forestcaver/Tides2_stuff/README.md

# Tides2_stuff
Panel, modified pcb to put the recom on the back, calibration stuff
(pcb and panel both verified - two modules built 11/4/19)
