forestcaver/Tides2_stuff/tides2_panel_AJH3.bmp

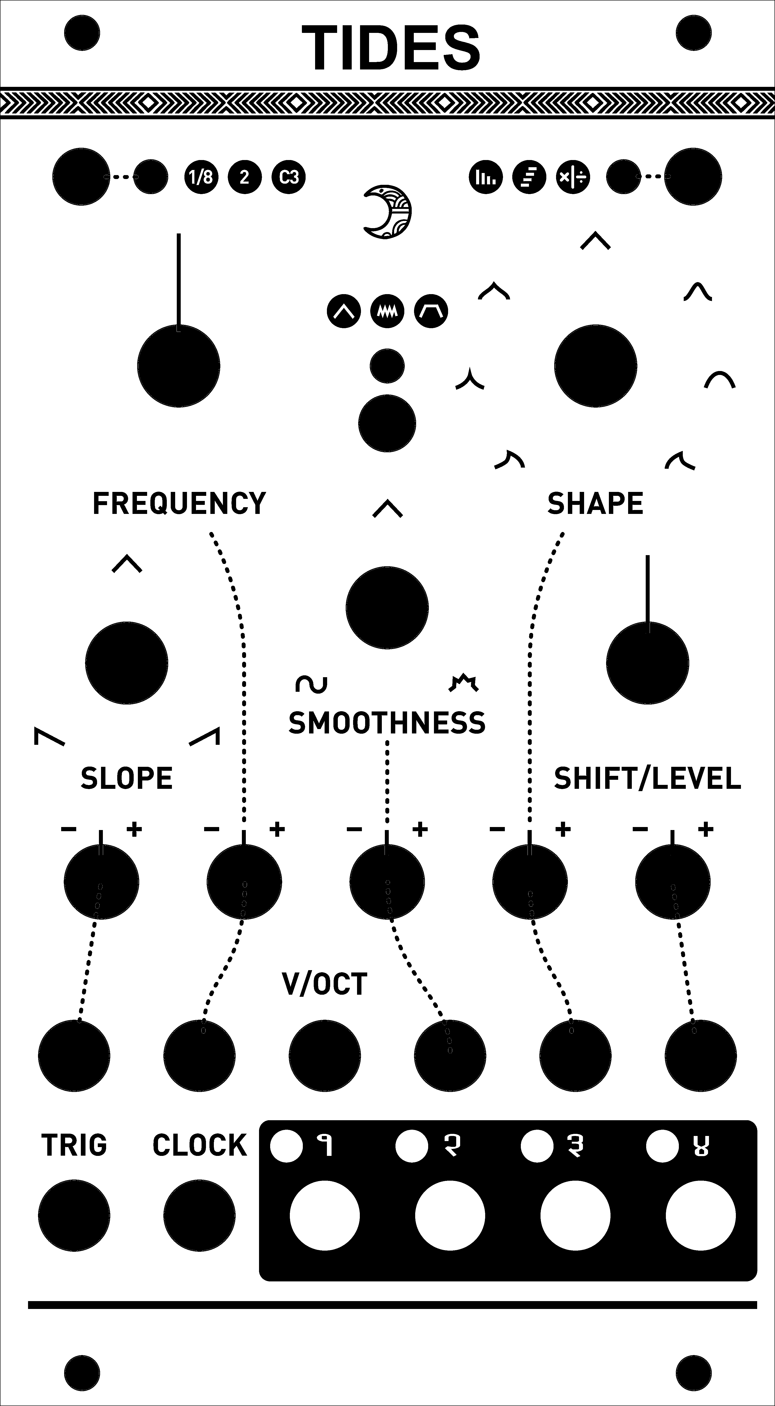
tides2_panel_AJH3.bmp
