forestcaver/Tides2_stuff/AJH_tides2_v40.brd

## EAGLE design AJH_tides2_v40.brd (2019-04-13)

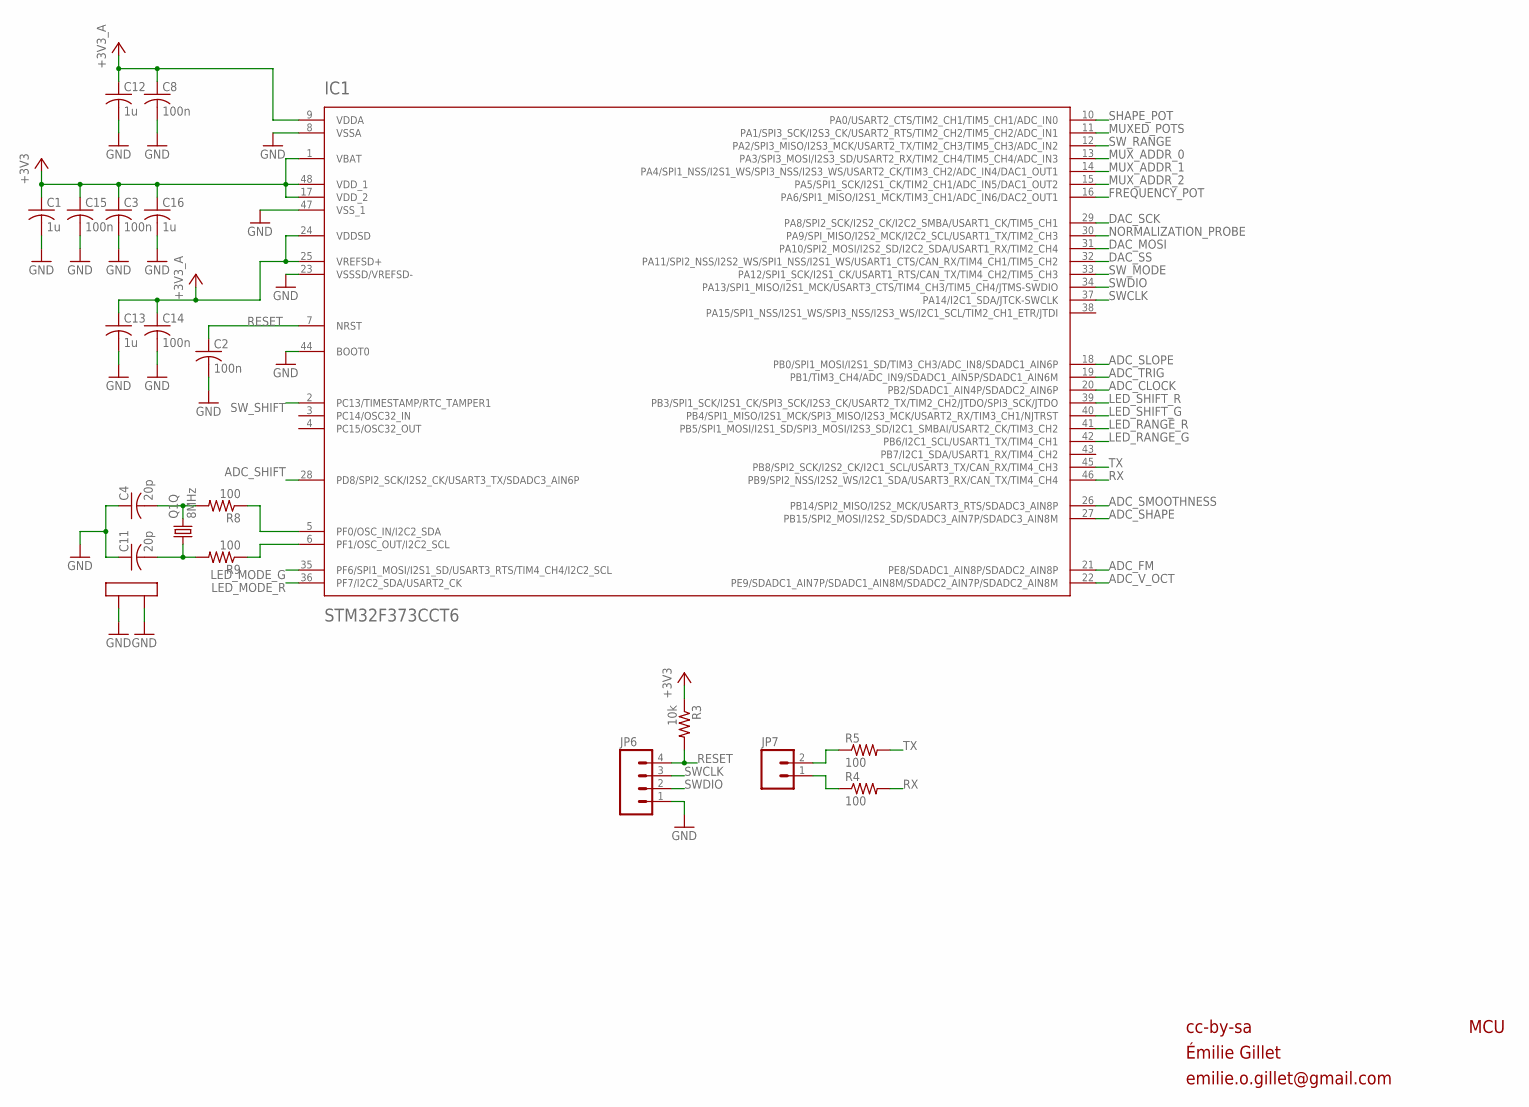
[picture p2: schematic AJH_tides2_v40.sch, sheet 1]

Parts:
C1, C12, C13, C16: 1u; C0402
C2, C3, C8, C14, C15: 100n; C0402
C4, C11: 20p; C0402
IC1: STM32F373CCT6; LQFP48
JP6: M04PTH; 1X04
JP7: M02PTH; 1X02
Q1: 8MHz; CTS406
R3: 10k; R0402
R4, R5, R8, R9: 100; R0402

Connections:
+3V3: C1.1, C3.1, C15.1, C16.1, IC1.1 (VBAT), IC1.17 (VDD_2), IC1.48 (VDD_1), R3.1; also elsewhere on the board
+3V3_A: C8.1, C12.1, C13.1, C14.1, IC1.9 (VDDA), IC1.24 (VDDSD), IC1.25 (VREFSD+); also elsewhere on the board
ADC_CLOCK: IC1.20 (PB2/SDADC1_AIN4P/SDADC2_AIN6P); also elsewhere on the board
ADC_FM: IC1.21 (PE8/SDADC1_AIN8P/SDADC2_AIN8P); also elsewhere on the board
ADC_SHAPE: IC1.27 (PB15/SPI2_MOSI/I2S2_SD/SDADC3_AIN7P/SDA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); also elsewhere on the board
ADC_SHIFT: IC1.28 (PD8/SPI2_SCK/I2S2_CK/USART3_TX/SDADC3_A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); also elsewhere on the board
ADC_SLOPE: IC1.18 (PB0/SPI1_MOSI/I2S1_SD/TIM3_CH3/ADC_IN8/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); also elsewhere on the board
ADC_SMOOTHNESS: IC1.26 (PB14/SPI2_MISO/I2S2_MCK/USART3_RTS/SDAD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); also elsewhere on the board
ADC_TRIG: IC1.19 (PB1/TIM3_CH4/ADC_IN9/SDADC1_AIN5P/SDADC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); also elsewhere on the board
ADC_V_OCT: IC1.22 (PE9/SDADC1_AIN7P/SDADC1_AIN8M/SDADC2_AI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); also elsewhere on the board
DAC_MOSI: IC1.31 (PA10/SPI2_MOSI/I2S2_SD/I2C2_SDA/USART1_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); also elsewhere on the board
DAC_SCK: IC1.29 (PA8/SPI2_SCK/I2S2_CK/I2C2_SMBA/USART1_C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); also elsewhere on the board
DAC_SS: IC1.32 (PA11/SPI2_NSS/I2S2_WS/SPI1_NSS/I2S1_WS/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); also elsewhere on the board
FREQUENCY_POT: IC1.16 (PA6/SPI1_MISO/I2S1_MCK/TIM3_CH1/ADC_IN6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); also elsewhere on the board
GND: C1.2, C2.2, C3.2, C4.1, C8.2, C11.1, C12.2, C13.2, C14.2, C15.2, C16.2, IC1.8 (VSSA), IC1.23 (VSSSD/VREFSD-), IC1.44 (BOOT0), IC1.47 (VSS_1), JP6.1, Q1.2 (LID1), Q1.4 (LID2); also elsewhere on the board
LED_MODE_G: IC1.35 (PF6/SPI1_MOSI/I2S1_SD/USART3_RTS/TIM4_C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); also elsewhere on the board
LED_MODE_R: IC1.36 (PF7/I2C2_SDA/USART2_CK); also elsewhere on the board
LED_RANGE_G: IC1.42 (PB6/I2C1_SCL/USART1_TX/TIM4_CH1); also elsewhere on the board
LED_RANGE_R: IC1.41 (PB5/SPI1_MOSI/I2S1_SD/SPI3_MOSI/I2S3_SD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); also elsewhere on the board
LED_SHIFT_G: IC1.40 (PB4/SPI1_MISO/I2S1_MCK/SPI3_MISO/I2S3_M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); also elsewhere on the board
LED_SHIFT_R: IC1.39 (PB3/SPI1_SCK/I2S1_CK/SPI3_SCK/I2S3_CK/U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); also elsewhere on the board
MUXED_POTS: IC1.11 (PA1/SPI3_SCK/I2S3_CK/USART2_RTS/TIM2_CH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); also elsewhere on the board
MUX_ADDR_0: IC1.13 (PA3/SPI3_MOSI/I2S3_SD/USART2_RX/TIM2_CH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); also elsewhere on the board
MUX_ADDR_1: IC1.14 (PA4/SPI1_NSS/I2S1_WS/SPI3_NSS/I2S3_WS/U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); also elsewhere on the board
MUX_ADDR_2: IC1.15 (PA5/SPI1_SCK/I2S1_CK/TIM2_CH1/ADC_IN5/D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); also elsewhere on the board
unnamed: IC1.5 (PF0/OSC_IN/I2C2_SDA), R8.1
unnamed: IC1.6 (PF1/OSC_OUT/I2C2_SCL), R9.1
unnamed: C4.2, Q1.3 (2), R8.2
unnamed: JP7.2, R5.1
unnamed: C11.2, Q1.1, R9.2
unnamed: JP7.1, R4.1
NORMALIZATION_PROBE: IC1.30 (PA9/SPI_MISO/I2S2_MCK/I2C2_SCL/USART1_T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); also elsewhere on the board
RESET: C2.1, IC1.7 (NRST), JP6.4, R3.2
RX: IC1.46 (PB9/SPI2_NSS/I2S2_WS/I2C1_SDA/USART3_RX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), R4.2
SHAPE_POT: IC1.10 (PA0/USART2_CTS/TIM2_CH1/TIM5_CH1/ADC_IN0); also elsewhere on the board
SWCLK: IC1.37 (PA14/I2C1_SDA/JTCK-SWCLK), JP6.3
SWDIO: IC1.34 (PA13/SPI1_MISO/I2S1_MCK/USART3_CTS/TIM4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), JP6.2
SW_MODE: IC1.33 (PA12/SPI1_SCK/I2S1_CK/USART1_RTS/CAN_TX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); also elsewhere on the board
SW_RANGE: IC1.12 (PA2/SPI3_MISO/I2S3_MCK/USART2_TX/TIM2_C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); also elsewhere on the board
SW_SHIFT: IC1.2 (PC13/TIMESTAMP/RTC_TAMPER1); also elsewhere on the board
TX: IC1.45 (PB8/SPI2_SCK/I2S2_CK/I2C1_SCL/USART3_TX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), R5.2

Notes on the sheet:
cc-by-sa
MCU
Émilie Gillet
emilie.o.gillet@gmail.com

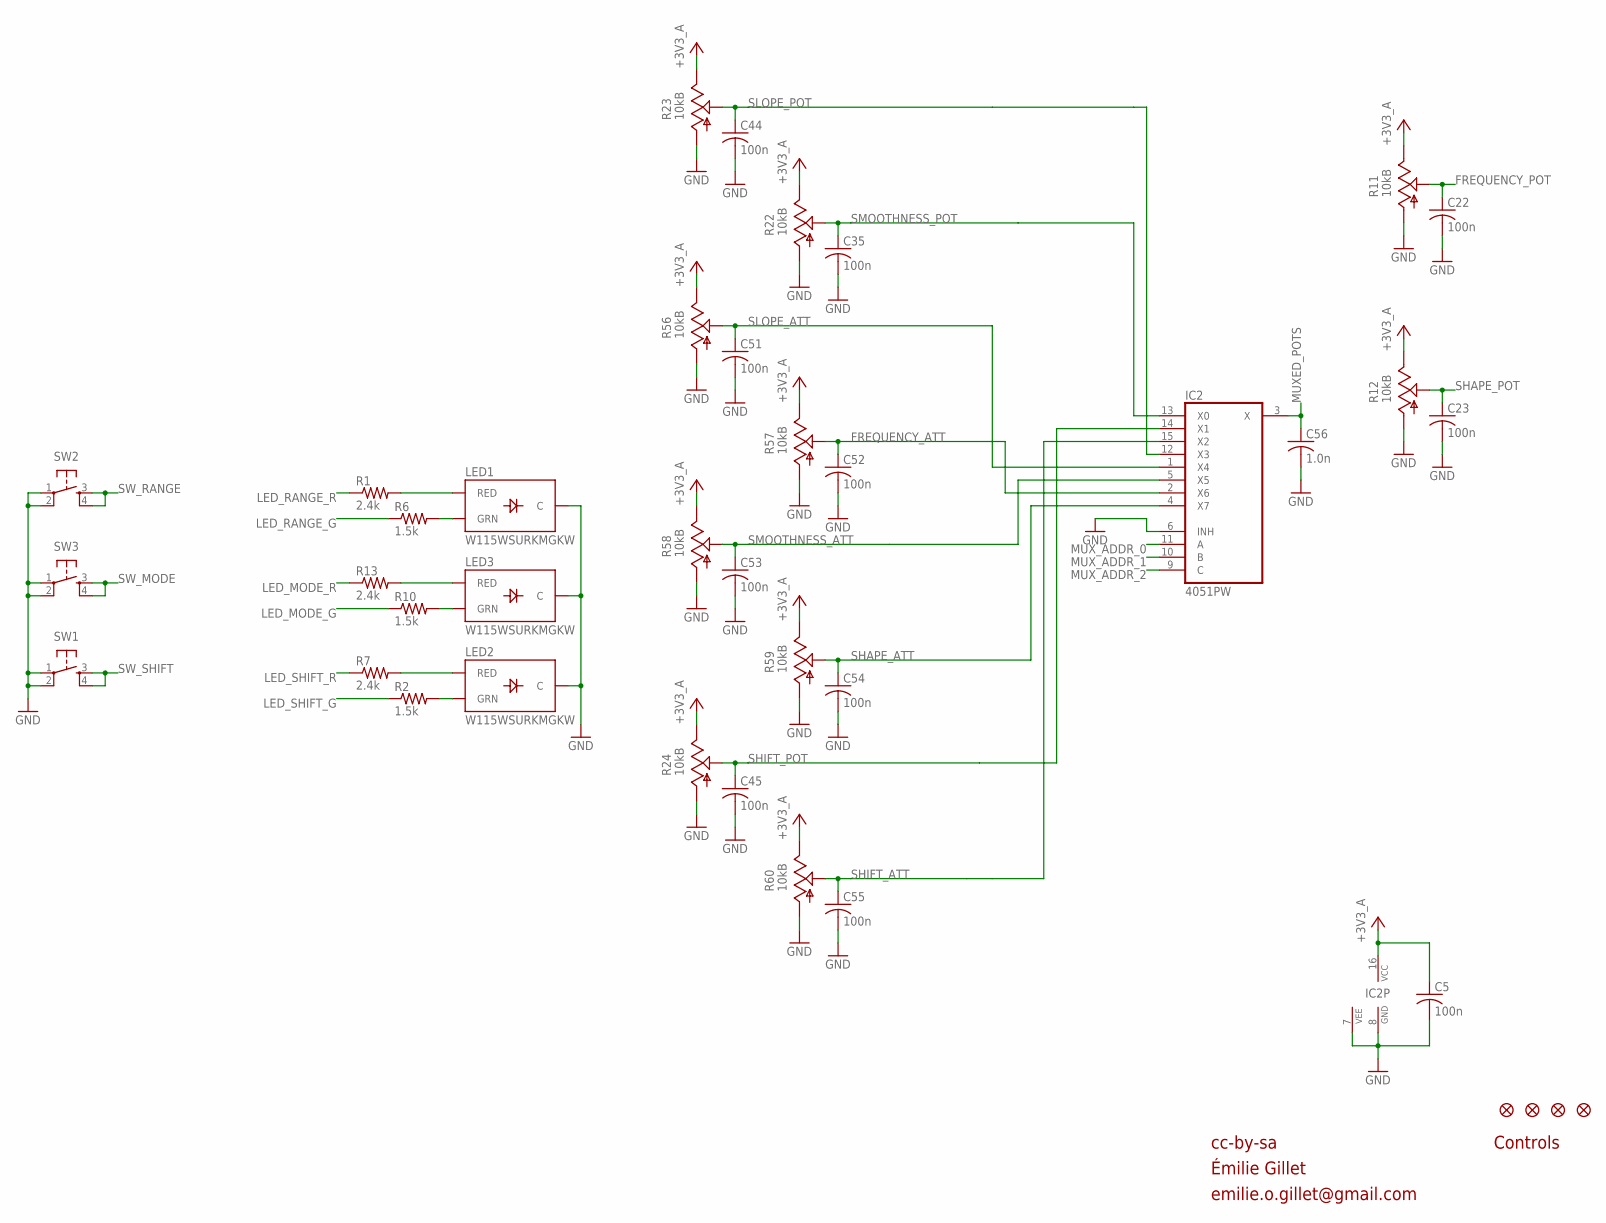
[picture p3: schematic AJH_tides2_v40.sch, sheet 2]

Parts:
C5, C22, C23, C35, C44, C45, C51, C52, C53, C54, C55: 100n; C0402
C56: 1.0n; C0402
IC2: 4051PW; TSSOP16_065
JP1, JP2, JP3, JP4: FIDUCIAL1X2; FIDUCIAL-1X2
LED1, LED2, LED3: W115WSURKMGKW; LED-BICOLOR-THROUGHHOLE-2.54
R1, R7, R13: 2.4k; R0402
R2, R6, R10: 1.5k; R0402
R11, R12, R22, R23, R24: 10kB; ALPS_POT_VERTICAL_PS
R56, R57, R58, R59, R60: 10kB; ALPS_POT_VERTICAL
SW1, SW2, SW3: TAC_SWITCHPTH; TACTILE-PTH

Connections:
+3V3_A: C5.1, IC2.16 (VCC), R11.P$1 (E), R12.P$1 (E), R22.P$1 (E), R23.P$1 (E), R24.P$1 (E), R56.P$1 (E), R57.P$1 (E), R58.P$1 (E), R59.P$1 (E), R60.P$1 (E); also elsewhere on the board
FREQUENCY_ATT: C52.1, IC2.2 (X6), R57.P$2 (S)
FREQUENCY_POT: C22.1, R11.P$2 (S); also elsewhere on the board
GND: C5.2, C22.2, C23.2, C35.2, C44.2, C45.2, C51.2, C52.2, C53.2, C54.2, C55.2, C56.2, IC2.6 (INH), IC2.7 (VEE), IC2.8 (GND), LED1.2 (C), LED2.2 (C), LED3.2 (C), R11.P$3 (A), R12.P$3 (A), R22.P$3 (A), R23.P$3 (A), R24.P$3 (A), R56.P$3 (A), R57.P$3 (A), R58.P$3 (A), R59.P$3 (A), R60.P$3 (A), SW1.1, SW1.2, SW2.1, SW2.2, SW3.1, SW3.2; also elsewhere on the board
LED_MODE_G: R10.1; also elsewhere on the board
LED_MODE_R: R13.1; also elsewhere on the board
LED_RANGE_G: R6.1; also elsewhere on the board
LED_RANGE_R: R1.1; also elsewhere on the board
LED_SHIFT_G: R2.1; also elsewhere on the board
LED_SHIFT_R: R7.1; also elsewhere on the board
MUXED_POTS: C56.1, IC2.3 (X); also elsewhere on the board
MUX_ADDR_0: IC2.11 (A); also elsewhere on the board
MUX_ADDR_1: IC2.10 (B); also elsewhere on the board
MUX_ADDR_2: IC2.9 (C); also elsewhere on the board
unnamed: LED1.3 (RED), R1.2
unnamed: LED3.3 (RED), R13.2
unnamed: LED3.1 (GRN), R10.2
unnamed: LED2.3 (RED), R7.2
unnamed: LED1.1 (GRN), R6.2
unnamed: LED2.1 (GRN), R2.2
SHAPE_ATT: C54.1, IC2.4 (X7), R59.P$2 (S)
SHAPE_POT: C23.1, R12.P$2 (S); also elsewhere on the board
SHIFT_ATT: C55.1, IC2.15 (X2), R60.P$2 (S)
SHIFT_POT: C45.1, IC2.14 (X1), R24.P$2 (S)
SLOPE_ATT: C51.1, IC2.1 (X4), R56.P$2 (S)
SLOPE_POT: C44.1, IC2.12 (X3), R23.P$2 (S)
SMOOTHNESS_ATT: C53.1, IC2.5 (X5), R58.P$2 (S)
SMOOTHNESS_POT: C35.1, IC2.13 (X0), R22.P$2 (S)
SW_MODE: SW3.3, SW3.4; also elsewhere on the board
SW_RANGE: SW2.3, SW2.4; also elsewhere on the board
SW_SHIFT: SW1.3, SW1.4; also elsewhere on the board

Notes on the sheet:
cc-by-sa
Controls
Émilie Gillet
emilie.o.gillet@gmail.com

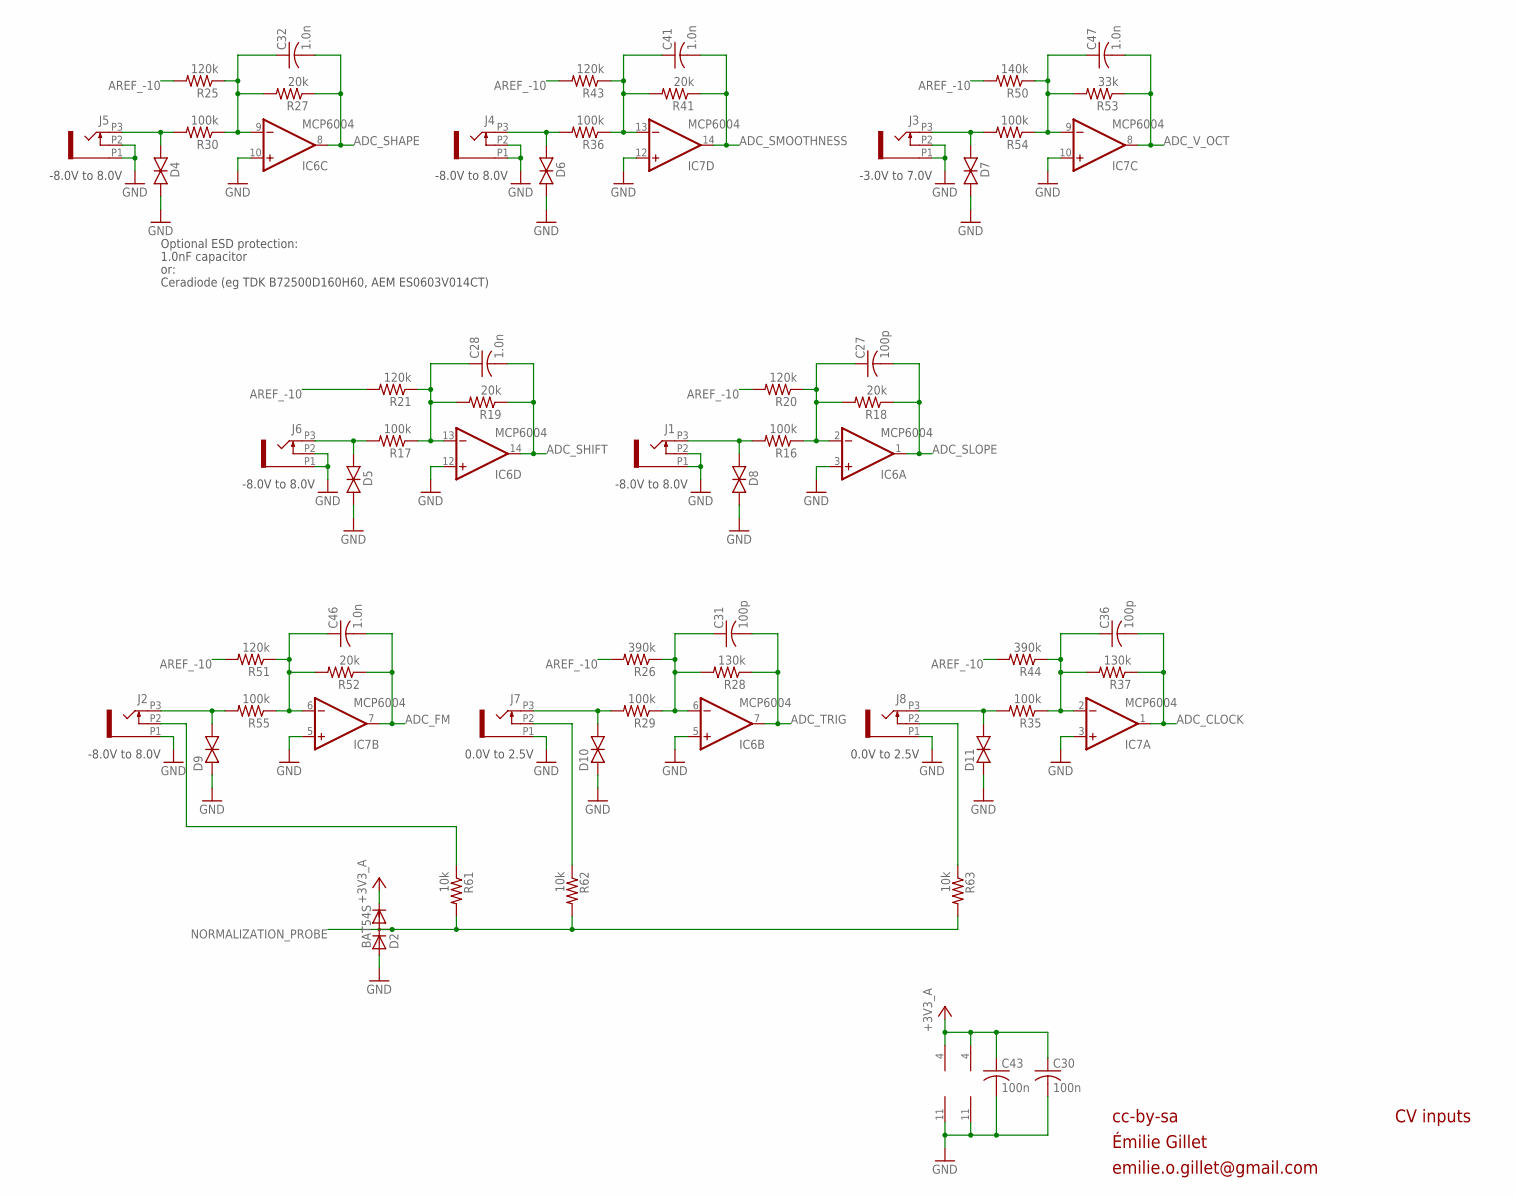
[picture p4: schematic AJH_tides2_v40.sch, sheet 3]

Parts:
C27, C31, C36: 100p; C0402
C28, C32, C41, C46, C47: 1.0n; C0402
C30, C43: 100n; C0402
D2: BAT54S; SOT23
D4, D5, D6, D7, D8, D9, D10, D11: TVS; 0603
IC6, IC7: MCP6004; TSSOP14_065
J1, J2, J3, J4, J5, J6, J7, J8: PJ301_THONKICONN6; WQP_PJ_301M6
R16, R17, R29, R30, R35, R36, R54, R55: 100k; R0402
R18, R19, R27, R41, R52: 20k; R0402
R20, R21, R25, R43, R51: 120k; R0402
R26, R44: 390k; R0402
R28, R37: 130k; R0402
R50: 140k; R0402
R53: 33k; R0402
R61, R62, R63: 10k; R0402

Connections:
+3V3_A: C30.1, C43.1, D2.2 (C), IC6.4 (V+), IC7.4 (V+); also elsewhere on the board
ADC_CLOCK: C36.2, IC7.1 (OUT), R37.1; also elsewhere on the board
ADC_FM: C46.2, IC7.7 (OUT), R52.1; also elsewhere on the board
ADC_SHAPE: C32.2, IC6.8 (OUT), R27.1; also elsewhere on the board
ADC_SHIFT: C28.2, IC6.14 (OUT), R19.1; also elsewhere on the board
ADC_SLOPE: C27.2, IC6.1 (OUT), R18.1; also elsewhere on the board
ADC_SMOOTHNESS: C41.2, IC7.14 (OUT), R41.1; also elsewhere on the board
ADC_TRIG: C31.2, IC6.7 (OUT), R28.1; also elsewhere on the board
ADC_V_OCT: C47.2, IC7.8 (OUT), R53.1; also elsewhere on the board
AREF_-10: R20.2, R21.2, R25.2, R26.2, R43.2, R44.2, R50.2, R51.2; also elsewhere on the board
CLOCK_IN: D11.2 (C), J8.P3 (3), R35.2
FM_IN: D9.2 (C), J2.P3 (3), R55.2
GND: C30.2, C43.2, D2.1 (A), D4.1 (A), D5.1 (A), D6.1 (A), D7.1 (A), D8.1 (A), D9.1 (A), D10.1 (A), D11.1 (A), IC6.3 (+IN), IC6.5 (+IN), IC6.10 (+IN), IC6.11 (V-), IC6.12 (+IN), IC7.3 (+IN), IC7.5 (+IN), IC7.10 (+IN), IC7.11 (V-), IC7.12 (+IN), J1.P1 (1), J1.P2 (2), J2.P1 (1), J3.P1 (1), J3.P2 (2), J4.P1 (1), J4.P2 (2), J5.P1 (1), J5.P2 (2), J6.P1 (1), J6.P2 (2), J7.P1 (1), J8.P1 (1); also elsewhere on the board
unnamed: J7.P2 (2), R62.1
unnamed: J8.P2 (2), R63.1
unnamed: C27.1, IC6.2 (-IN), R16.1, R18.2, R20.1
unnamed: J2.P2 (2), R61.1
unnamed: C28.1, IC6.13 (-IN), R17.1, R19.2, R21.1
unnamed: C47.1, IC7.9 (-IN), R50.1, R53.2, R54.1
unnamed: C46.1, IC7.6 (-IN), R51.1, R52.2, R55.1
unnamed: C31.1, IC6.6 (-IN), R26.1, R28.2, R29.1
unnamed: C32.1, IC6.9 (-IN), R25.1, R27.2, R30.1
unnamed: C36.1, IC7.2 (-IN), R35.1, R37.2, R44.1
unnamed: C41.1, IC7.13 (-IN), R36.1, R41.2, R43.1
NORMALIZATION_PROBE: D2.3 (AC), R61.2, R62.2, R63.2; also elsewhere on the board
SHAPE_IN: D4.2 (C), J5.P3 (3), R30.2
SHIFT_IN: D5.2 (C), J6.P3 (3), R17.2
SLOPE_IN: D8.2 (C), J1.P3 (3), R16.2
SMOOTHNESS_IN: D6.2 (C), J4.P3 (3), R36.2
TRIG_IN: D10.2 (C), J7.P3 (3), R29.2
V_OCT_IN: D7.2 (C), J3.P3 (3), R54.2

Notes on the sheet:
cc-by-sa
CV inputs
-8.0V to 8.0V
-3.0V to 7.0V
0.0V to 2.5V
Optional ESD protection:
1.0nF capacitor
or:
Ceradiode (eg TDK B72500D160H60, AEM ES0603V014CT)
Émilie Gillet
emilie.o.gillet@gmail.com

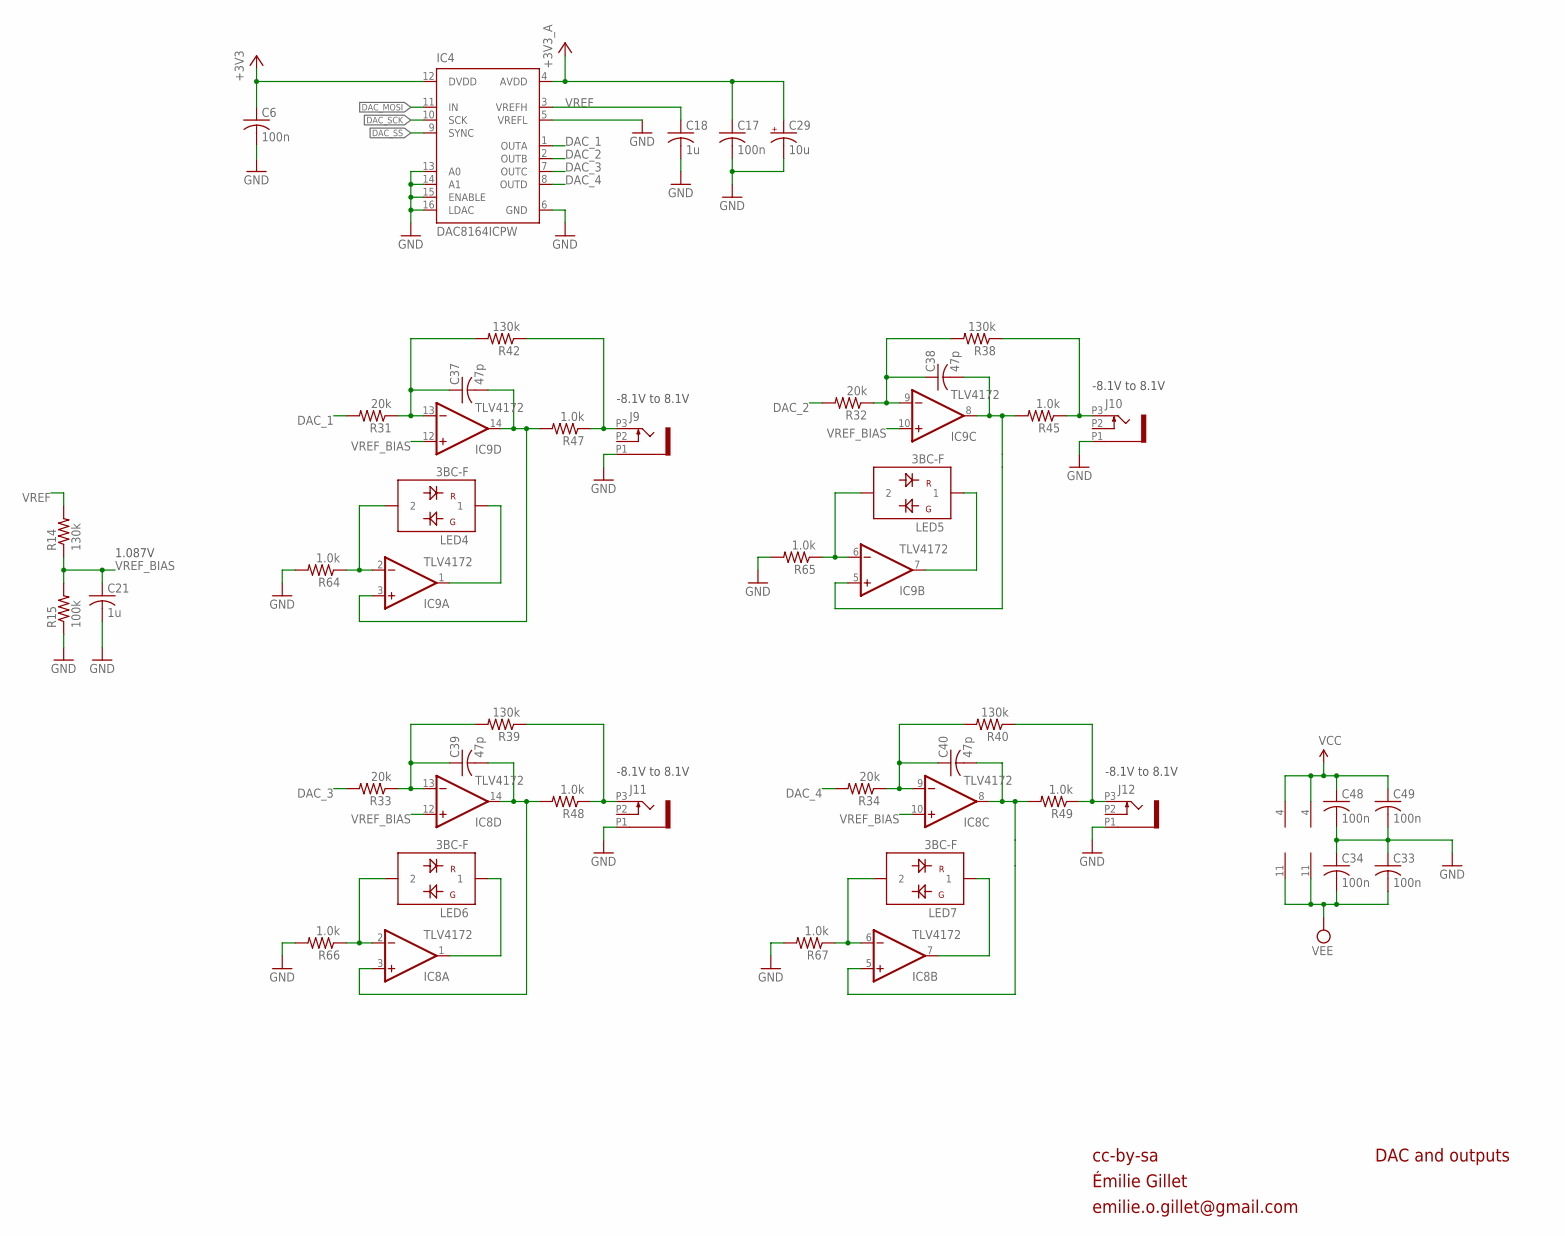
[picture p5: schematic AJH_tides2_v40.sch, sheet 4]

Parts:
C6, C17, C33, C34, C48, C49: 100n; C0402
C18, C21: 1u; C0402
C29: 10u; PANASONIC_A
C37, C38, C39, C40: 47p; C0402
IC4: DAC8164ICPW; SOP65P640X110-16N
IC8, IC9: TLV4172; TSSOP14_065
J9, J10, J11, J12: PJ301_THONKICONN6; WQP_PJ_301M6
LED4, LED5, LED6, LED7: 3BC-F; LED3MM
R14, R38, R39, R40, R42: 130k; R0402
R15: 100k; R0402
R31, R32, R33, R34: 20k; R0402
R45, R47, R48, R49: 1.0k; R0603
R64, R65, R66, R67: 1.0k; R0402

Connections:
+3V3: C6.1, IC4.12 (DVDD); also elsewhere on the board
+3V3_A: C17.1, C29.+, IC4.4 (AVDD); also elsewhere on the board
DAC_1: IC4.1 (OUTA), R31.2
DAC_2: IC4.2 (OUTB), R32.2
DAC_3: IC4.7 (OUTC), R33.2
DAC_4: IC4.8 (OUTD), R34.2
DAC_MOSI: IC4.11 (IN); also elsewhere on the board
DAC_SCK: IC4.10 (SCK); also elsewhere on the board
DAC_SS: IC4.9 (SYNC); also elsewhere on the board
GND: C6.2, C17.2, C18.2, C21.2, C29.-, C33.1, C34.1, C48.2, C49.2, IC4.5 (VREFL), IC4.6 (GND), IC4.13 (A0), IC4.14 (A1), IC4.15 (ENABLE), IC4.16 (LDAC), J9.P1 (1), J10.P1 (1), J11.P1 (1), J12.P1 (1), R15.1, R64.2, R65.2, R66.2, R67.2; also elsewhere on the board
unnamed: C37.2, IC9.3 (+IN), IC9.14 (OUT), R47.2
unnamed: J11.P3 (3), R39.1, R48.1
unnamed: J9.P3 (3), R42.1, R47.1
unnamed: C39.1, IC8.13 (-IN), R33.1, R39.2
unnamed: J12.P3 (3), R40.1, R49.1
unnamed: C40.1, IC8.9 (-IN), R34.1, R40.2
unnamed: C38.1, IC9.9 (-IN), R32.1, R38.2
unnamed: C37.1, IC9.13 (-IN), R31.1, R42.2
unnamed: J10.P3 (3), R38.1, R45.1
unnamed: IC9.2 (-IN), LED4.2, R64.1
unnamed: IC9.1 (OUT), LED4.1
unnamed: C38.2, IC9.5 (+IN), IC9.8 (OUT), R45.2
unnamed: IC9.6 (-IN), LED5.2, R65.1
unnamed: IC9.7 (OUT), LED5.1
unnamed: C39.2, IC8.3 (+IN), IC8.14 (OUT), R48.2
unnamed: IC8.2 (-IN), LED6.2, R66.1
unnamed: IC8.1 (OUT), LED6.1
unnamed: C40.2, IC8.5 (+IN), IC8.8 (OUT), R49.2
unnamed: IC8.6 (-IN), LED7.2, R67.1
unnamed: IC8.7 (OUT), LED7.1
VCC: C48.1, C49.1, IC8.4 (V+), IC9.4 (V+); also elsewhere on the board
VEE: C33.2, C34.2, IC8.11 (V-), IC9.11 (V-); also elsewhere on the board
VREF: C18.1, IC4.3 (VREFH), R14.2
VREF_BIAS: C21.1, IC8.10 (+IN), IC8.12 (+IN), IC9.10 (+IN), IC9.12 (+IN), R14.1, R15.2

Notes on the sheet:
cc-by-sa
DAC and outputs
-8.1V to 8.1V
1.087V
Émilie Gillet
emilie.o.gillet@gmail.com

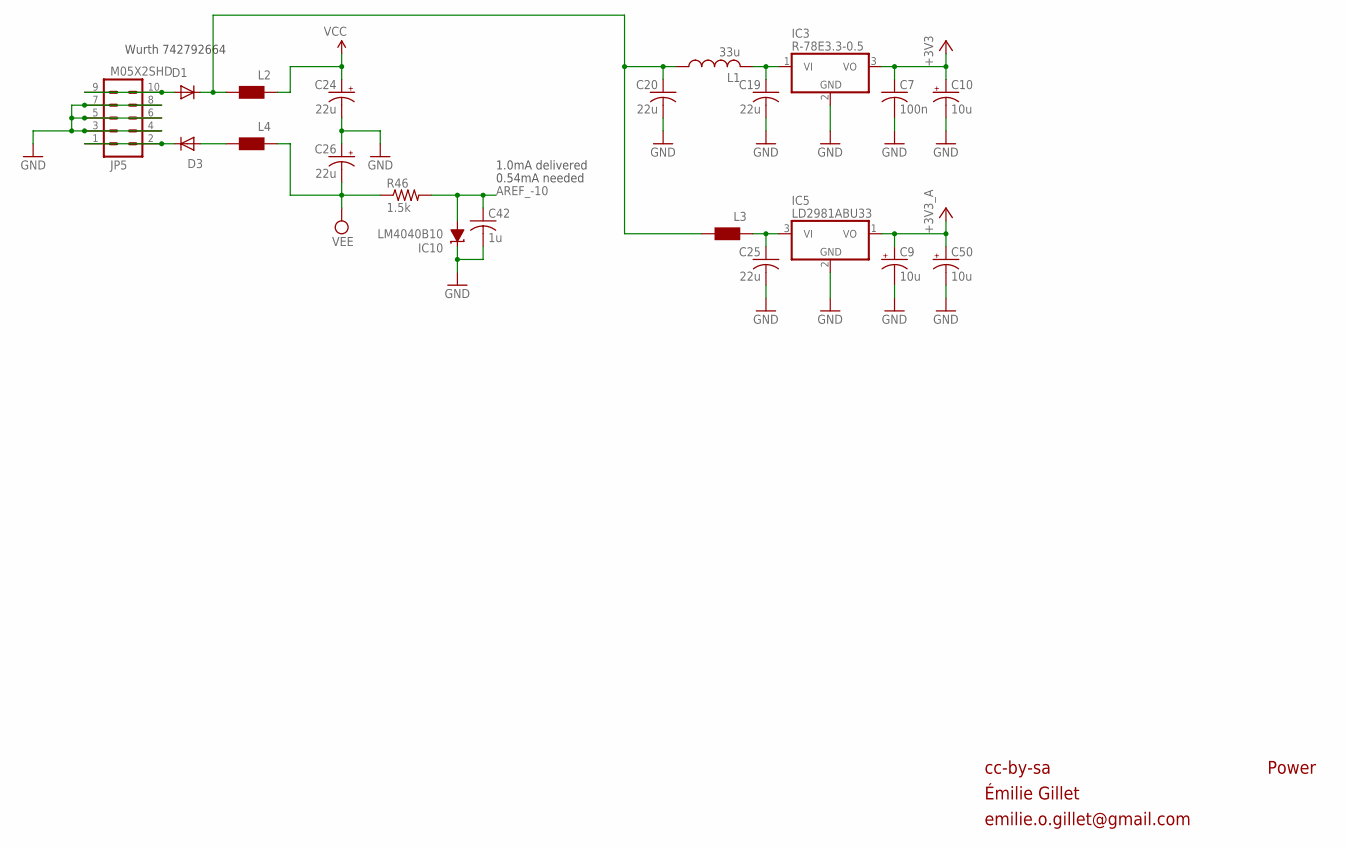
[picture p6: schematic AJH_tides2_v40.sch, sheet 5]

Parts:
C7: 100n; C0402
C9, C10, C50: 10u; PANASONIC_A
C19, C20, C25: 22u; C1206
C24, C26: 22u; PANASONIC_B
C42: 1u; C0402
D1, D3: 1N5819HW; SOD123
IC3: R-78E3.3-0.5; WE78
IC5: LD2981ABU33; SOT89
IC10: LM4040B10; DBZ_R-PDSO-G3
JP5: M05X2SHD; 2X5-SHROUDED
L1: 33u; L2012C
L2, L3, L4: WE-CBF_0603; 0603
R46: 1.5k; R0402

Connections:
+3V3: C7.1, C10.+, IC3.3 (VO); also elsewhere on the board
+3V3_A: C9.+, C50.+, IC5.1 (VO); also elsewhere on the board
AREF_-10: C42.1, IC10.2 (A), R46.2; also elsewhere on the board
GND: C7.2, C9.-, C10.-, C19.2, C20.2, C24.-, C25.2, C26.+, C42.2, C50.-, IC3.2 (GND), IC5.2 (GND), IC10.1 (C), JP5.3, JP5.4, JP5.5, JP5.6, JP5.7, JP5.8; also elsewhere on the board
unnamed: C19.1, IC3.1 (VI), L1.2
unnamed: D3.A, L4.2
unnamed: C20.1, D1.C, L1.1, L2.2, L3.2
unnamed: C25.1, IC5.3 (VI), L3.1
unnamed: D1.A, JP5.9, JP5.10
unnamed: D3.C, JP5.1, JP5.2
VCC: C24.+, L2.1; also elsewhere on the board
VEE: C26.-, L4.1, R46.1; also elsewhere on the board

Notes on the sheet:
cc-by-sa
Power
0.54mA needed
Wurth 742792664
1.0mA delivered
Émilie Gillet
emilie.o.gillet@gmail.com

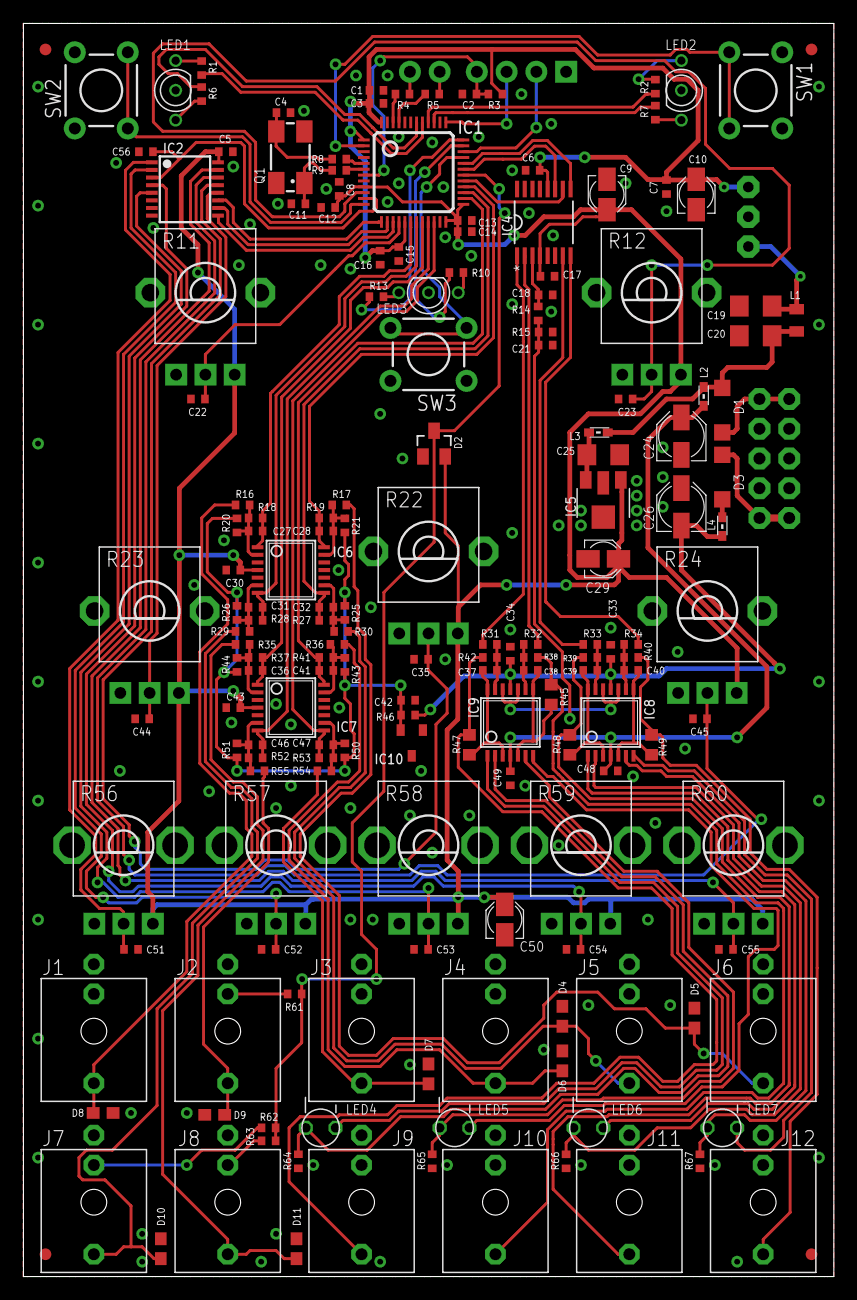
[picture p7: board AJH_tides2_v40.brd from above]

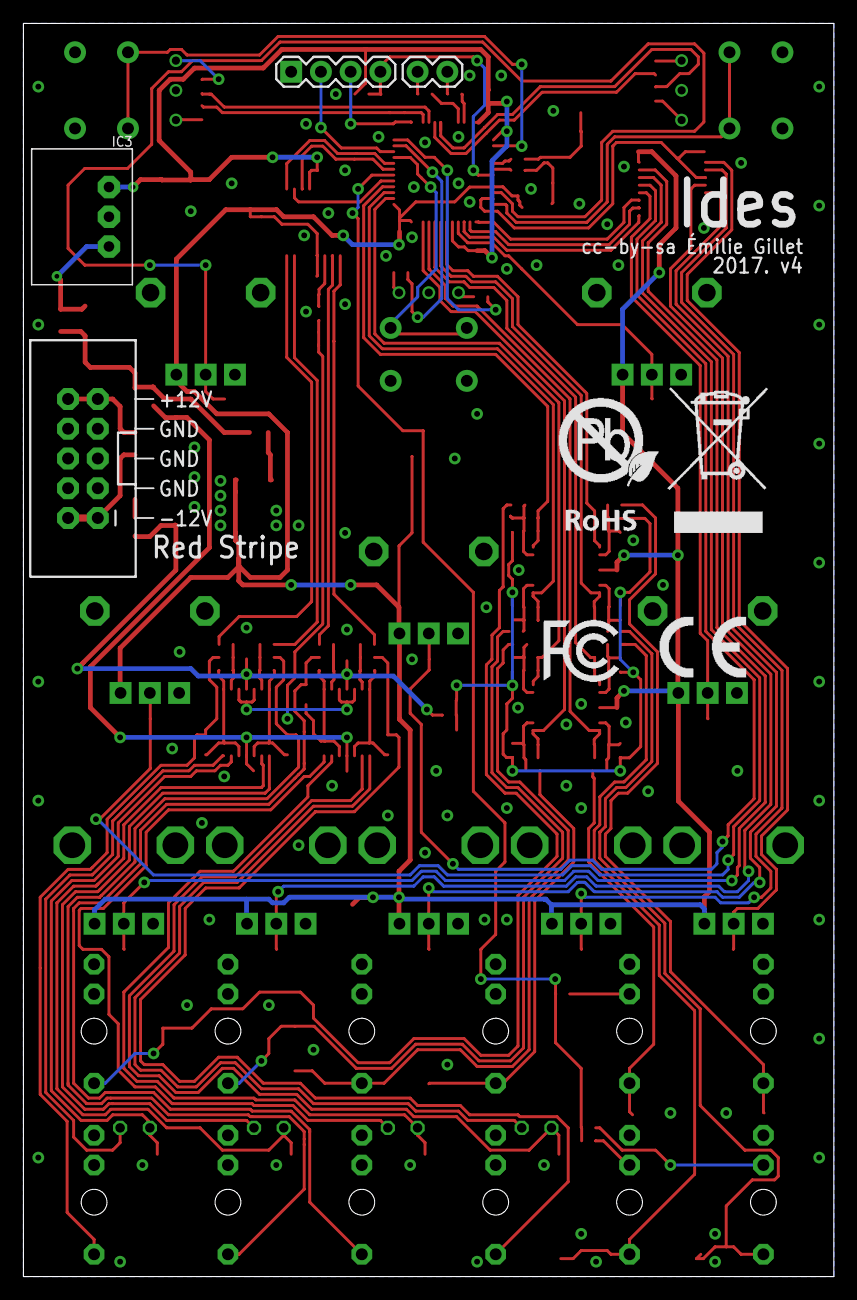
[picture p8: board AJH_tides2_v40.brd from below]

Board: 2 copper layers, 69.2 x 107.0 mm, 181 parts (7 on the bottom side), 109 nets.

Other parts of the board:
U$2: ROHS_BIG
U$4: CE_MEDIUM
U$5: FCC_MEDIUM
