forestcaver/Tides2_stuff/Tides2_calibration.xls

Sheet: Export Summary
This document was exported from Numbers. Each table was converted to an Excel worksheet. All other objects on each Numbers sheet were placed on separate worksheets. Please be aware that formula calculations may differ in Excel.
Numbers Sheet Name | Numbers Table Name | Excel Worksheet Name
Tides2
 | Table 1 | Tides2
Marbles
 | Table 1 | Marbles
Stages module 2
 | Table 1 | Stages module 2
Stages module 1
 | Table 1 | Stages module 1

Sheet: Tides2
Table 1
Module 1 | DAC | 1v | 3v | Target v1 | Target v2 | Actual scale | Actual offset | dac_code1 | dac_code2 | Target dac_code 1 | Target dac_code 2 | Scale | Offset
 | 1 | 1.00971 | 3.01435 | 1 | 3 | -4032.9 | 32768.0 | 28735.1 | 20669.3 | 28773.88288 | 20726.89661 | -4023.493133 | 32797.37601
 | 2 | 1.00105 | 3.0028 | 1 | 3 | -4032.9 | 32768.0 | 28735.1 | 20669.3 | 28739.3301 | 20680.58159 | -4029.374256 | 32768.70436
 | 3 | 1.01332 | 3.01016 | 1 | 3 | -4032.9 | 32768.0 | 28735.1 | 20669.3 | 28788.11211 | 20710.13597 | -4038.98807 | 32827.10018
 | 4 | 0.99929 | 3.00293 | 1 | 3 | -4032.9 | 32768.0 | 28735.1 | 20669.3 | 28732.23461 | 20681.10487 | -4025.564869 | 32757.79948
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
