forestcaver/Tides2_stuff/settings.cc

// Copyright 2017 Emilie Gillet.
//
// Author: Emilie Gillet (emilie.o.gillet@gmail.com)
//
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
// See http://creativecommons.org/licenses/MIT/ for more information.
//
// -----------------------------------------------------------------------------
//
// Settings storage.

#include "tides2/settings.h"

#include <algorithm>
#include <cmath>

#include "stmlib/system/storage.h"

namespace tides {

using namespace std;

#define FIX_OUTLIER(destination, expected_value) if (fabsf(destination / expected_value - 1.0f) > 0.25f) { destination = expected_value; }
#define FIX_OUTLIER_ABSOLUTE(destination, expected_value) if (fabsf(destination - expected_value) > 0.1f) { destination = expected_value; }

bool Settings::Init() {
  DacCalibrationData default_dac_calibration_data;
  default_dac_calibration_data.scale = -4032.9f;
  default_dac_calibration_data.offset = 32768.0f;
  
  AdcCalibrationData default_adc_calibration_data;
  default_adc_calibration_data.scale = -1.0f;
  default_adc_calibration_data.offset = 0.0f;
  
  fill(
      &persistent_data_.dac_calibration[0],
      &persistent_data_.dac_calibration[kNumCvOutputs],
      default_dac_calibration_data);

  fill(
      &persistent_data_.adc_calibration[0],
      &persistent_data_.adc_calibration[kNumParameters],
      default_adc_calibration_data);
  
  // Calibration data for the V/O and FM CV input.
  persistent_data_.adc_calibration[0].scale = -60.0f;
  persistent_data_.adc_calibration[0].offset = +25.68f;
  persistent_data_.adc_calibration[1].scale = -96.0f;
  persistent_data_.adc_calibration[1].offset = +0.0f;

  // AJH
  persistent_data_.dac_calibration[0].offset = 32768.0f;
  persistent_data_.dac_calibration[0].scale = -4032.9f;
  persistent_data_.dac_calibration[1].offset = 32768.0f;
  persistent_data_.dac_calibration[1].scale = -4032.9f;
  persistent_data_.dac_calibration[2].offset = 32768.0f;
  persistent_data_.dac_calibration[2].scale = -4032.9f;
  persistent_data_.dac_calibration[3].offset = 32768.0f;
  persistent_data_.dac_calibration[3].scale = -4032.9f;


#if 0
  // Module 1

  persistent_data_.dac_calibration[0].offset = 32797.3760102878f;
  persistent_data_.dac_calibration[0].scale = -4023.49313302604f;
  persistent_data_.dac_calibration[1].offset = 32768.7043598294f;
  persistent_data_.dac_calibration[1].scale = -4029.37425643796f;
  persistent_data_.dac_calibration[2].offset = 32827.1001770101f;
  persistent_data_.dac_calibration[2].scale = -4038.98807027188f;
  persistent_data_.dac_calibration[3].offset = 32757.7994760663f;
  persistent_data_.dac_calibration[3].scale = -4025.56486949567f;
#endif
#if 1
  // Module 2

  persistent_data_.dac_calibration[0].offset = 32902.1334919328f;
  persistent_data_.dac_calibration[0].scale = -4026.10519651008f;
  persistent_data_.dac_calibration[1].offset = 32991.1247939371f;
  persistent_data_.dac_calibration[1].scale = -4021.9416964069f;
  persistent_data_.dac_calibration[2].offset = 33009.2570409587f;
  persistent_data_.dac_calibration[2].scale = -4025.56579866493f;
  persistent_data_.dac_calibration[3].offset = 32940.4900931101f;
  persistent_data_.dac_calibration[3].scale = -4013.09119589374f;


#endif
  // End AJH
  
  state_.mode = 1;
  state_.range = 2;
  state_.output_mode = 0;
  
  bool success = chunk_storage_.Init(&persistent_data_, &state_);
  
  if (success) {
    // Sanitize settings read from flash.
    FIX_OUTLIER(persistent_data_.adc_calibration[0].scale, -60.0f);
    FIX_OUTLIER(persistent_data_.adc_calibration[0].offset, +25.68f);
    FIX_OUTLIER(persistent_data_.adc_calibration[1].scale, -96.0f);
    
    if (fabsf(persistent_data_.adc_calibration[1].offset) > 10.0f) {
      persistent_data_.adc_calibration[1].offset = 0.0f;
    }
    for (int i = 0; i < 4; ++i) {
      FIX_OUTLIER(persistent_data_.adc_calibration[i + 2].scale, -1.0f);
      FIX_OUTLIER_ABSOLUTE(persistent_data_.adc_calibration[i + 2].offset, 0);
      FIX_OUTLIER(persistent_data_.dac_calibration[i].scale, -4032.9f);
      FIX_OUTLIER(persistent_data_.dac_calibration[i].offset, 32768.0f);
    }
    CONSTRAIN(state_.mode, 0, 2);
    CONSTRAIN(state_.range, 0, 2);
    CONSTRAIN(state_.output_mode, 0, 3);
  }
  
  return success;
}

void Settings::SavePersistentData() {
  chunk_storage_.SavePersistentData();
}

void Settings::SaveState() {
  chunk_storage_.SaveState();
}

}  // namespace tides
