forestcaver/Tides2_stuff/(notices)

Notices in the files:
AJH_tides2_v40.brd:
cc-by-sa Émilie Gillet
